aggrc/TURTLE/README.md

# TURTLE
Open Source Temperature Logger using Arduino, Max31856 breakout board, and thermocouples
