aggrc/TURTLE/Case V3/TURTLE_Case_TopV3.stl

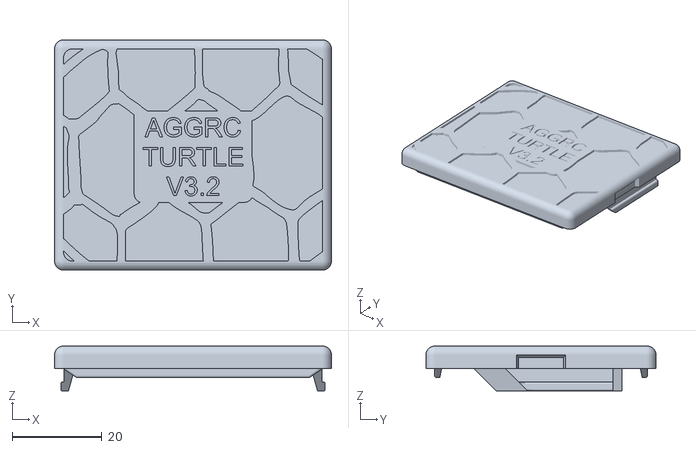
[picture p2: CAD file, 2026-10-08]
Case V3/TURTLE_Case_TopV3.stl
61.6 x 51.2 x 10.0
