aggrc/TURTLE/(list of files, cad)

Other CAD files:
Case V3/TURTLE_Case_BaseV3.f3d
Case V3/TURTLE_Case_TopV3.f3d
